RTroMT/F4_2kW_Smart-Power-Outlet/220VAC_PowerMeter/220VAC_PowerMeter.csv

Id | Designator | Footprint | Quantity | Designation | Supplier and ref
1 | C1, C7 | C_0805_2012Metric_Pad1.18x1.45mm_HandSolder | 2 | 100nF
2 | C2, C3 | C_Rect_L11.0mm_W5.1mm_P10.00mm_MKT | 2 | 33nF
3 | C4 | CP_Radial_D5.0mm_P2.50mm | 1 | 100uF
4 | C5 | C_0805_2012Metric_Pad1.18x1.45mm_HandSolder | 1 | 33nF
5 | C6 | CP_Radial_D5.0mm_P2.00mm | 1 | 1uF
6 | CONN_5V | PinHeader_1x02_P2.54mm_Vertical | 1 | PinHeader_1x02_P2.54mm_Vertical
7 | D1 | D_DO-41_SOD81_P3.81mm_Vertical_AnodeUp | 1 | 5.1V
8 | D2, D3 | LED_D3.0mm | 2 | LED
9 | F1 | Fuseholder_Clip-5x20mm_Eaton_1A5601-01_Inline_P20.80x6.76mm_D1.70mm_Horizontal | 1 | Fuse
10 | J1 | TerminalBlock_Ningbo-Kagnex_HB9500_1x02_P9.5mm | 1 | AC_OUT
11 | J2 | PinHeader_1x20_P2.54mm_Vertical | 1 | Conn_01x20_Pin
12 | J3 | TerminalBlock_Ningbo-Kagnex_HB9500_1x02_P9.5mm | 1 | AC_IN
13 | J4, J5 | PinSocket_1x20_P2.54mm_Vertical | 2 | Conn_01x20_Socket
14 | J6 | JST_XH_B2B-XH-A_1x02_P2.50mm_Vertical | 1 | SW_Conn
15 | J7 | PinHeader_1x20_P2.54mm_Vertical | 1 | ~
16 | J8 | IDC-Header_2x07_P2.54mm_Vertical | 1 | TFT_Conn
17 | J9 | JST_XH_B2B-XH-A_1x02_P2.50mm_Vertical | 1 | SSR_CTRL
18 | Q1 | TO-92_Inline | 1 | PN2222A
19 | R1 | R_Axial_DIN0207_L6.3mm_D2.5mm_P10.16mm_Horizontal | 1 | 0.001R
20 | R2, R3, R10, R17 | R_Axial_DIN0207_L6.3mm_D2.5mm_P7.62mm_Horizontal | 4 | 1k 1/4W
21 | R4, R5, R6, R7 | R_Axial_DIN0207_L6.3mm_D2.5mm_P10.16mm_Horizontal | 4 | 470k 1/2W
22 | R8 | R_Axial_DIN0207_L6.3mm_D2.5mm_P10.16mm_Horizontal | 1 | 1k 1/4W
23 | R9, R11 | R_Axial_DIN0207_L6.3mm_D2.5mm_P7.62mm_Horizontal | 2 | 470
24 | R12, R14 | R_Axial_DIN0207_L6.3mm_D2.5mm_P7.62mm_Horizontal | 2 | 10k
25 | R13 | R_Axial_DIN0207_L6.3mm_D2.5mm_P7.62mm_Horizontal | 1 | 2.2k
26 | R15, R16 | R_Axial_DIN0207_L6.3mm_D2.5mm_P7.62mm_Horizontal | 2 | 1k
27 | RV1 | RV_Disc_D12mm_W5.4mm_P7.5mm | 1 | 10D471K
28 | U1 | Converter_ACDC_Hi-Link_HLK-5Mxx | 1 | HLK-5M05
29 | U2 | Converter_DCDC_Murata_MEE1SxxxxSC_THT | 1 | MEE1S0505SC
30 | U3 | SOIC-8_3.9x4.9mm_P1.27mm | 1 | HLW8032
31 | U4, U5, U6 | DIP-4_W7.62mm_LongPads | 3 | PC817
