RTroMT/F4_2kW_Smart-Power-Outlet/220VAC_PowerMeter/220VAC_PowerMeter.pdf

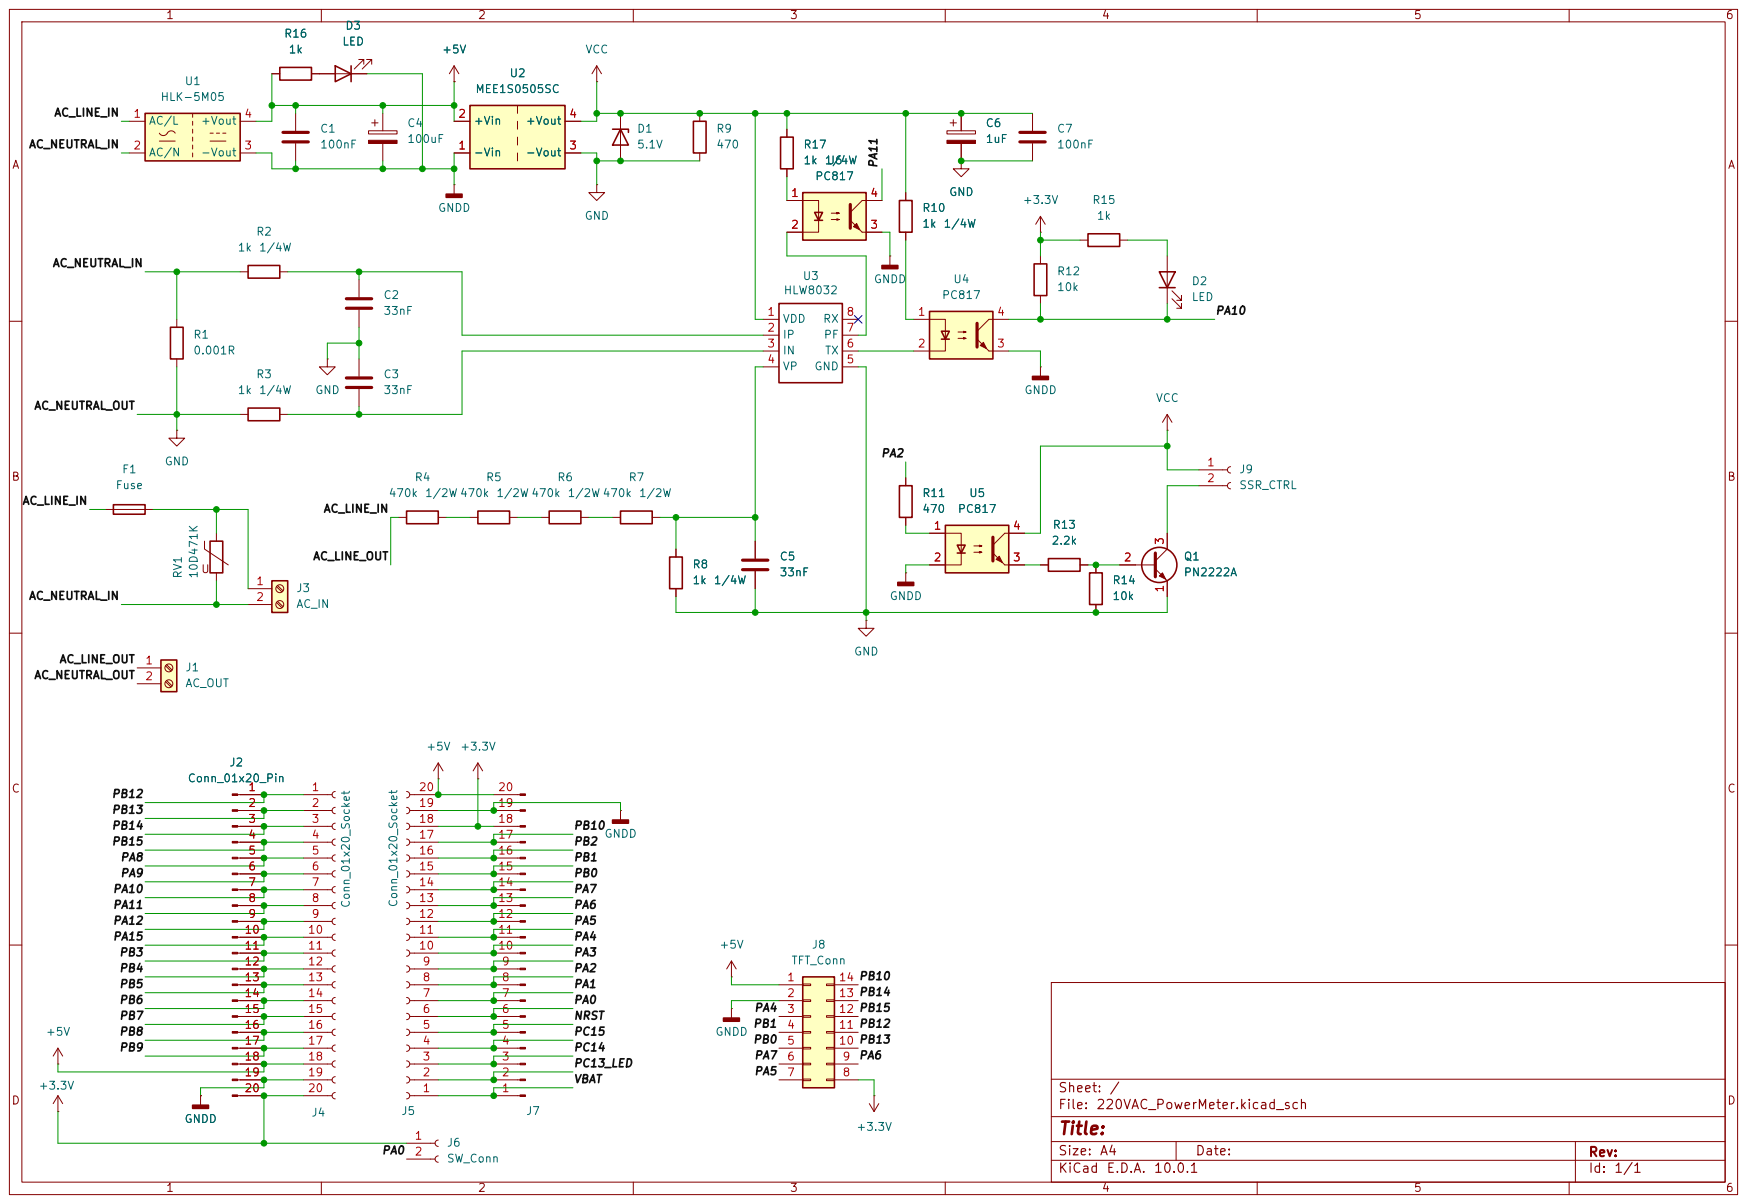
[picture p1: page 1]

Size: A4 | Rev:
KiCad E.D.A. 10.0.1 | Id: 1/1
