RTroMT/F4_2kW_Smart-Power-Outlet/220VAC_PowerMeter/220VAC_PowerMeter.kicad_pcb

## KiCad design 220VAC_PowerMeter/220VAC_PowerMeter.kicad_pcb (2026-10-09)

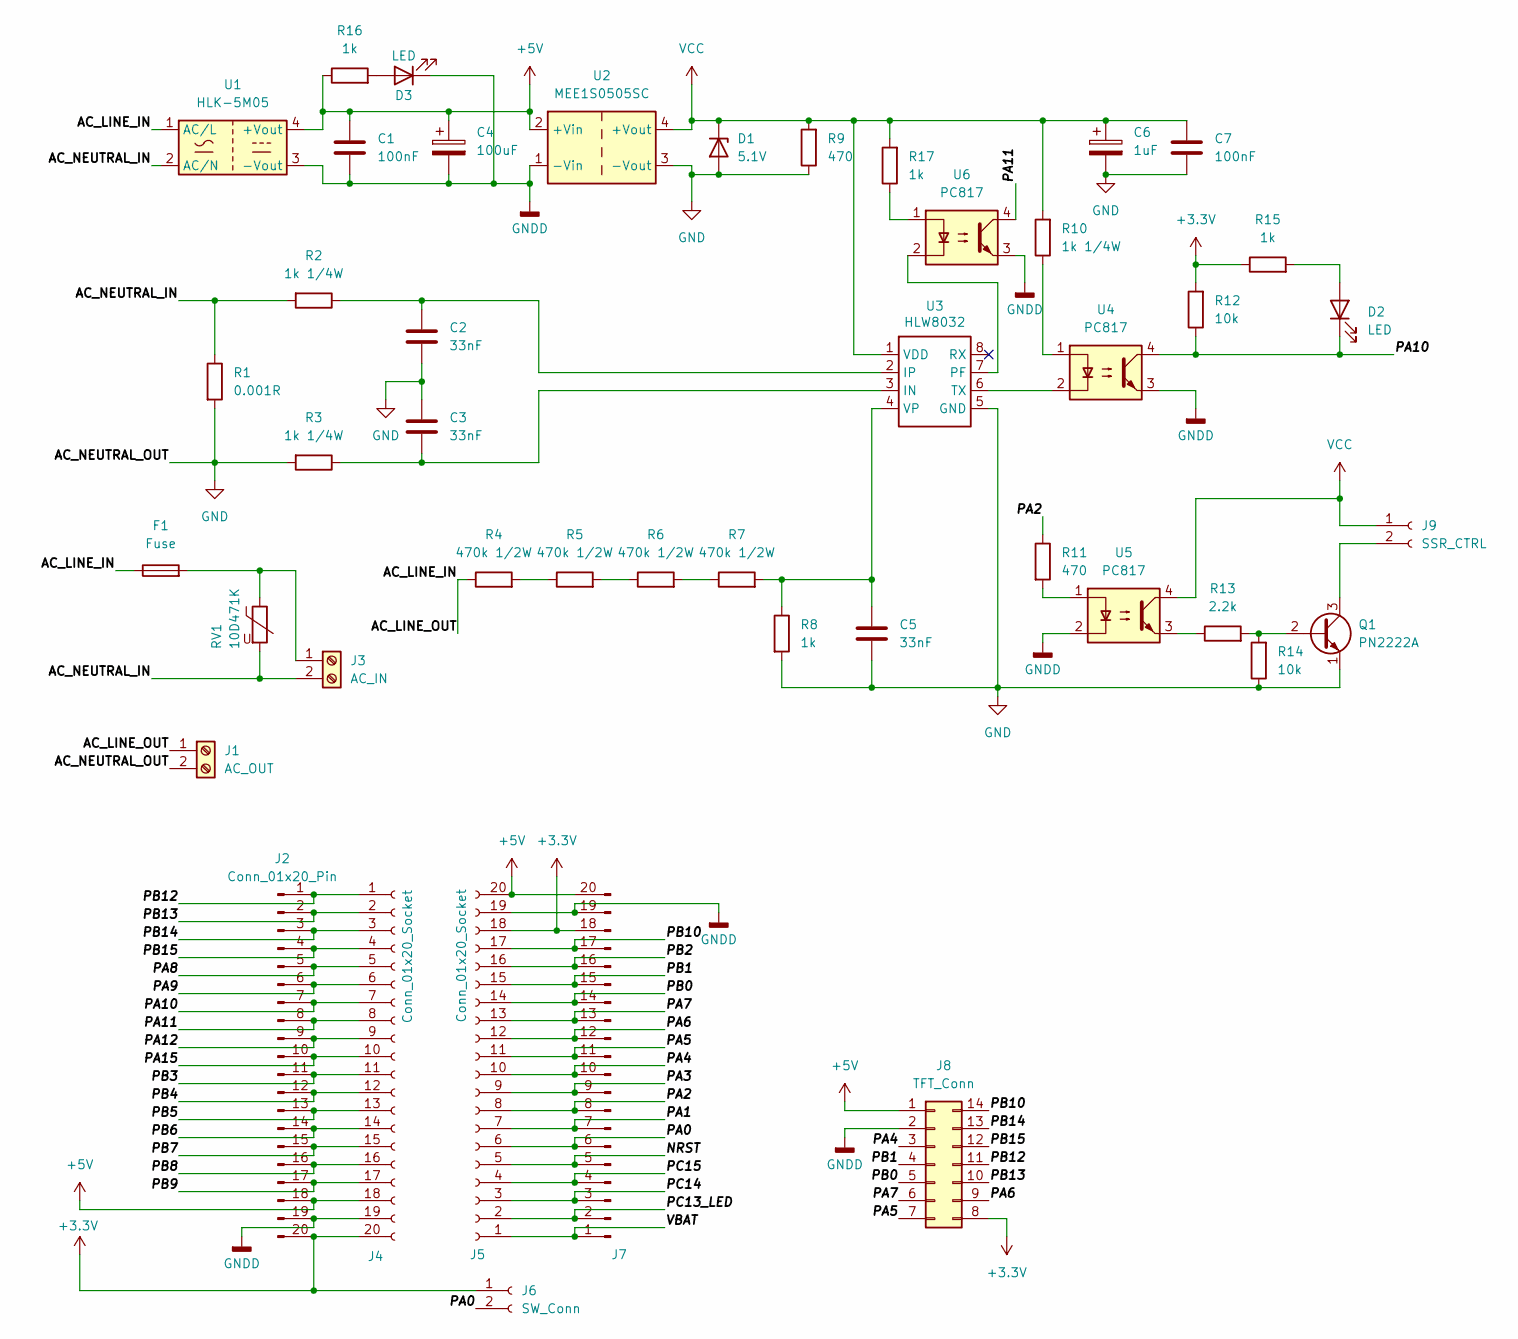
[picture p2: schematic 220VAC_PowerMeter.kicad_sch]

Parts:
C1, C7: 100nF; C_0805_2012Metric_Pad1.18x1.45mm_HandSolder
C2, C3: 33nF; C_Rect_L11.0mm_W5.1mm_P10.00mm_MKT
C4: 100uF; CP_Radial_D5.0mm_P2.50mm
C5: 33nF; C_0805_2012Metric_Pad1.18x1.45mm_HandSolder
C6: 1uF; CP_Radial_D5.0mm_P2.00mm
D1: 5.1V; D_DO-41_SOD81_P3.81mm_Vertical_AnodeUp
D2, D3: LED; LED_D3.0mm
F1: Fuse; Fuseholder_Clip-5x20mm_Eaton_1A5601-01_Inline_P20.80x6.76mm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
J1: AC_OUT; TerminalBlock_Ningbo-Kagnex_HB9500_1x02_P9.5mm
J2: Conn_01x20_Pin; PinHeader_1x20_P2.54mm_Vertical
J3: AC_IN; TerminalBlock_Ningbo-Kagnex_HB9500_1x02_P9.5mm
J4, J5: Conn_01x20_Socket; PinSocket_1x20_P2.54mm_Vertical
J6: SW_Conn; JST_XH_B2B-XH-A_1x02_P2.50mm_Vertical
J7: PinHeader_1x20_P2.54mm_Vertical
J8: TFT_Conn; IDC-Header_2x07_P2.54mm_Vertical
J9: SSR_CTRL; JST_XH_B2B-XH-A_1x02_P2.50mm_Vertical
Q1: PN2222A; TO-92_Inline
R1: 0.001R; R_Axial_DIN0207_L6.3mm_D2.5mm_P10.16mm_Horizontal
R2, R3, R10: 1k 1/4W; R_Axial_DIN0207_L6.3mm_D2.5mm_P7.62mm_Horizontal
R4, R5, R6, R7: 470k 1/2W; R_Axial_DIN0207_L6.3mm_D2.5mm_P10.16mm_Horizontal
R8: 1k; R_Axial_DIN0207_L6.3mm_D2.5mm_P10.16mm_Horizontal
R9, R11: 470; R_Axial_DIN0207_L6.3mm_D2.5mm_P7.62mm_Horizontal
R12, R14: 10k; R_Axial_DIN0207_L6.3mm_D2.5mm_P7.62mm_Horizontal
R13: 2.2k; R_Axial_DIN0207_L6.3mm_D2.5mm_P7.62mm_Horizontal
R15, R16, R17: 1k; R_Axial_DIN0207_L6.3mm_D2.5mm_P7.62mm_Horizontal
RV1: 10D471K; RV_Disc_D12mm_W5.4mm_P7.5mm
U1: HLK-5M05; Converter_ACDC_Hi-Link_HLK-5Mxx
U2: MEE1S0505SC; Converter_DCDC_Murata_MEE1SxxxxSC_THT
U3: HLW8032; SOIC-8_3.9x4.9mm_P1.27mm
U4, U5, U6: PC817; DIP-4_W7.62mm_LongPads

Connections:
+3.3V: J2.20, J4.20, J5.18, J6.1, J7.18, J8.8, R12.2, R15.1
+5V: C1.1, C4.1, J2.18, J4.18, J5.20, J7.20, J8.1, R16.1, U1.4 (+Vout), U2.2 (+Vin); also elsewhere on the board
/AC_LINE_IN: F1.1, J1.1, R4.1, U1.1 (AC/L)
/AC_NEUTRAL_IN: J3.2, R1.1, R2.2, RV1.2, U1.2 (AC/N)
/NRST: J5.5, J7.5
/PA0: J5.6, J6.2, J7.6
/PA1: J5.7, J7.7
/PA2: J5.8, J7.8, R11.1
/PA3: J5.9, J7.9
/PA4: J5.10, J7.10, J8.3
/PA5: J5.11, J7.11, J8.7
/PA6: J5.12, J7.12, J8.9
/PA7: J5.13, J7.13, J8.6
/PA8: J2.5, J4.5
/PA9: J2.6, J4.6
/PA10: D2.1 (K), J2.7, J4.7, R12.1, U4.4
/PA11: J2.8, J4.8, U6.4
/PA12: J2.9, J4.9
/PA15: J2.10, J4.10
/PB0: J5.14, J7.14, J8.5
/PB1: J5.15, J7.15, J8.4
/PB2: J5.16, J7.16
/PB3: J2.11, J4.11
/PB4: J2.12, J4.12
/PB5: J2.13, J4.13
/PB6: J2.14, J4.14
/PB7: J2.15, J4.15
/PB8: J2.16, J4.16
/PB9: J2.17, J4.17
/PB10: J5.17, J7.17, J8.14
/PB12: J2.1, J4.1, J8.11
/PB13: J2.2, J4.2, J8.10
/PB14: J2.3, J4.3, J8.13
/PB15: J2.4, J4.4, J8.12
/PC13_LED: J5.2, J7.2
/PC14: J5.3, J7.3
/PC15: J5.4, J7.4
/VBAT: J5.1, J7.1
GND: C2.2, C3.1, C5.2, C6.2, C7.2, D1.2 (A), J1.2, Q1.1 (E), R1.2, R3.2, R8.2, R9.1, R14.1, U2.3 (-Vout), U3.5 (GND)
GNDD: C1.2, C4.2, D3.1 (K), J2.19, J4.19, J5.19, J7.19, J8.2, U1.3 (-Vout), U2.1 (-Vin), U4.3, U5.2, U6.3; also elsewhere on the board
unnamed: D2.2 (A), R15.2
unnamed: D3.2 (A), R16.2
unnamed: F1.2, J3.1, RV1.1
unnamed: J9.2, Q1.3 (C)
unnamed: Q1.2 (B), R13.2, R14.2
unnamed: R4.2, R5.1
unnamed: R5.2, R6.1
unnamed: R6.2, R7.1
unnamed: R10.1, U4.1
unnamed: R11.2, U5.1
unnamed: R13.1, U5.3
unnamed: R17.1, U6.1
unnamed: C3.2, R3.1, U3.3 (IN)
unnamed: C2.1, R2.1, U3.2 (IP)
unnamed: U3.7 (PF), U6.2
unnamed: U3.6 (TX), U4.2
unnamed: C5.1, R7.2, R8.1, U3.4 (VP)
VCC: C6.1, C7.1, D1.1 (K), J9.1, R9.2, R10.2, R17.2, U2.4 (+Vout), U3.1 (VDD), U5.4

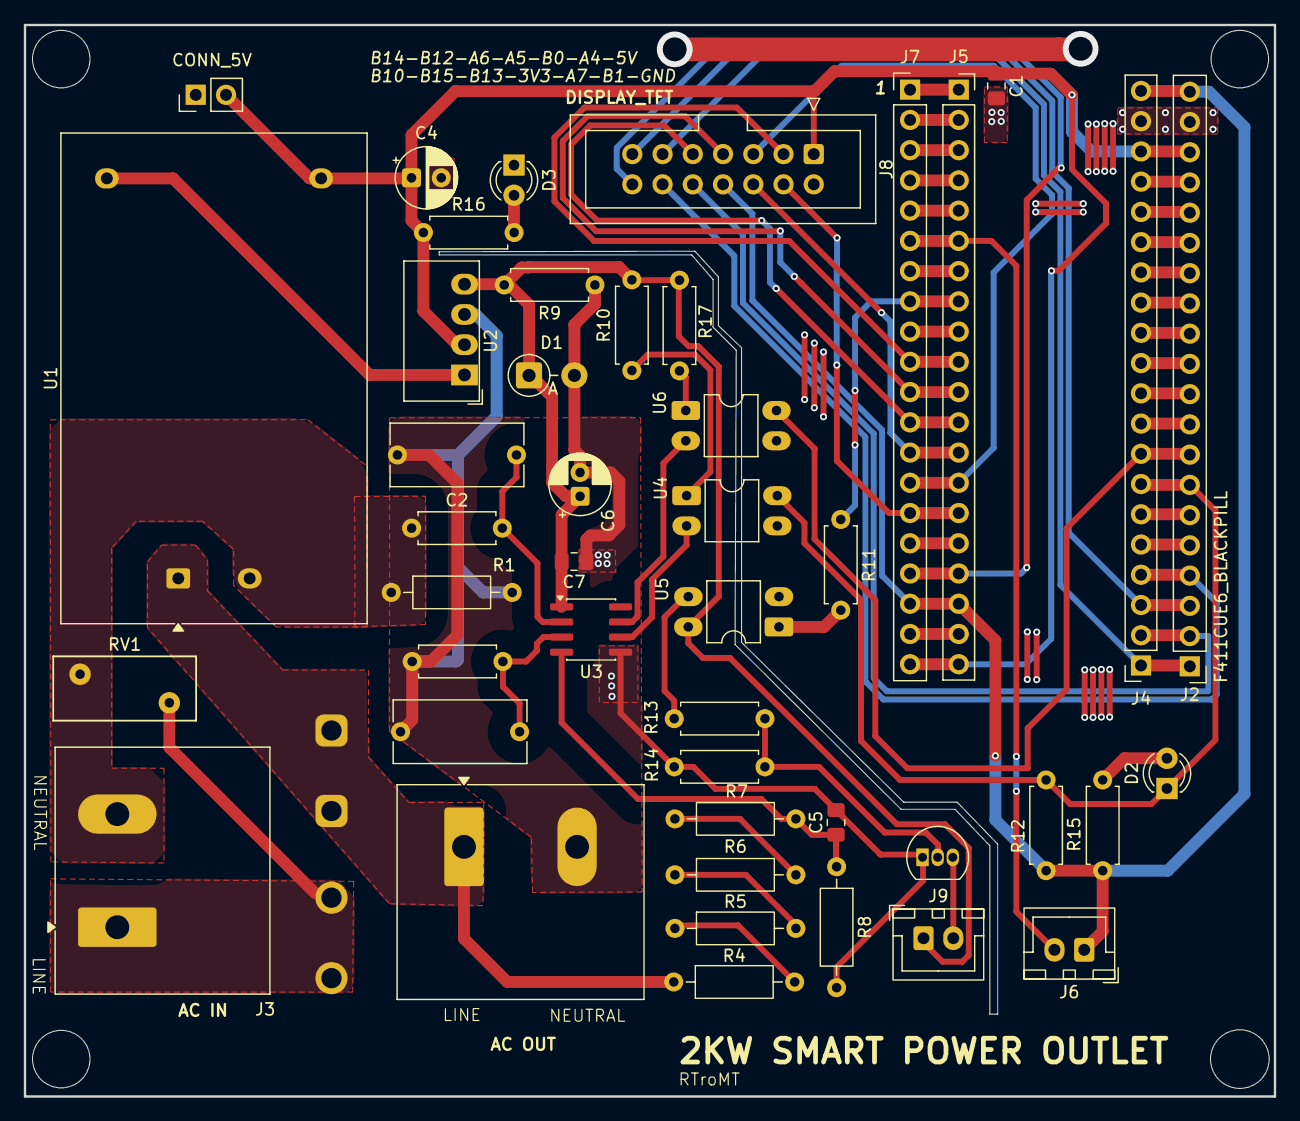
[picture p3: board 220VAC_PowerMeter.kicad_pcb from above]

Board: 2 copper layers, 105.0 x 90.0 mm, 46 parts (1 on the bottom side), 58 nets.

Other parts of the board:
CONN_5V: PinHeader_1x02_P2.54mm_Vertical

Their connections:
+5V: CONN_5V.2; also elsewhere on the board
GNDD: CONN_5V.1; also elsewhere on the board
