RTroMT/F4_2kW_Smart-Power-Outlet/Src_STM32/2kW_SmartOutlet/2kW_SmartOutlet.ioc

Mcu.UserName=STM32F401CCUx
PA0-WKUP.GPIO_Label=SW_MAIN
PA0-WKUP.Signal=GPIO_Input
PA10.Signal=USART1_RX
PA11.Signal=USART6_TX
PA12.Signal=USART6_RX
PA13.Signal=SYS_JTMS-SWDIO
PA14.Signal=SYS_JTCK-SWCLK
PA2.GPIO_Label=SSR_CTRL
PA2.Signal=GPIO_Output
PA4.GPIO_Label=TFT_CS
PA4.Signal=GPIO_Output
PA5.Signal=SPI1_SCK
PA6.Signal=SPI1_MISO
PA7.Signal=SPI1_MOSI
PA9.Signal=USART1_TX
PB0.GPIO_Label=TFT_A0
PB0.Signal=GPIO_Output
PB1.GPIO_Label=TFT_RESET
PB1.Signal=GPIO_Output
PB10.GPIO_Label=TOUCH_IRQ
PB10.Signal=GPIO_Input
PB12.GPIO_Label=TOUCH_CS
PB12.Signal=GPIO_Output
PB13.GPIO_Label=TOUCH_CLK
PB13.Signal=GPIO_Output
PB14.GPIO_Label=TOUCH_DO
PB14.Signal=GPIO_Input
PB15.GPIO_Label=TOUCH_DIN
PB15.Signal=GPIO_Output
PC13-ANTI_TAMP.GPIO_Label=LED_BUILTIN
PC13-ANTI_TAMP.Signal=GPIO_Output
