RTroMT/F4_2kW_Smart-Power-Outlet/Src_STM32/2kW_SmartOutlet/Core/Inc/main.h

#define LED_BUILTIN_Pin GPIO_PIN_13
#define LED_BUILTIN_GPIO_Port GPIOC
#define SW_MAIN_Pin GPIO_PIN_0
#define SW_MAIN_GPIO_Port GPIOA
#define SSR_CTRL_Pin GPIO_PIN_2
#define SSR_CTRL_GPIO_Port GPIOA
#define TFT_CS_Pin GPIO_PIN_4
#define TFT_CS_GPIO_Port GPIOA
#define TFT_A0_Pin GPIO_PIN_0
#define TFT_A0_GPIO_Port GPIOB
#define TFT_RESET_Pin GPIO_PIN_1
#define TFT_RESET_GPIO_Port GPIOB
#define TOUCH_IRQ_Pin GPIO_PIN_10
#define TOUCH_IRQ_GPIO_Port GPIOB
#define TOUCH_CS_Pin GPIO_PIN_12
#define TOUCH_CS_GPIO_Port GPIOB
#define TOUCH_CLK_Pin GPIO_PIN_13
#define TOUCH_CLK_GPIO_Port GPIOB
#define TOUCH_DO_Pin GPIO_PIN_14
#define TOUCH_DO_GPIO_Port GPIOB
#define TOUCH_DIN_Pin GPIO_PIN_15
#define TOUCH_DIN_GPIO_Port GPIOB
