RTroMT/F4_2kW_Smart-Power-Outlet/(notices)

Notices in the files:
Src_STM32/2kW_SmartOutlet/Core/Src/main.c:
Copyright (c) 2026 STMicroelectronics.
All rights reserved.
This software is licensed under terms that can be found in the LICENSE file
